Misha-Belov/Pneumatic-Joint/README.md

# Pneumatic-Joint
fabrika-project

## 📌 Описание
Проект представляет собой прототип суставана на базе микроконтроллера **ESP32**, изгибающегося за счёт перераспределения давления в эластичных камерах - мышцах. Управление и передача информации с датчика гироскопа в рельном времени осуществляется через Wi-Fi.

## 👨‍🔧 Участники проекта

- **Белов М.С. Б01-302**
- **Мартыненко Е.В. Б01-302** 

## 🎯 Цель проекта

Создание прототипа сустава на ESP32 с дальнейшей возможностью расширения на полноценный манипулятор.

## 🛠 Задачи

1. Подбор компонентов
2. Создание 3D-модели и электронной схемы
3. Написание прошивки
4. Сборка системы

## 🧩 Архитектура устройства

- **ESP32** с поддержкой Wi-Fi
- **Гироскоп-акселерометр** MPU6050
- **Понижатель напряжения**
- **3 соленоидных клапана**
- **Пневматическая система**

## 🆚 Аналоги и отличия

**Аналоги:**
- [Пневматический манипулятор на Habr]([https://habr.com/ru/articles/814127/](https://www.instructables.com/Soft-Robots-Make-An-Artificial-Muscle-Arm-And-Gri/))

**Отличительные особенности:**
- Значительно упрощённая пневматическая система
- Расширяемая архитектура для новых модулей
