Misha-Belov/Pneumatic-Joint/docs/Презентация1.pptx

## Пневматический сустав

Белов Михаил, Мартыненко Егор Б01-302

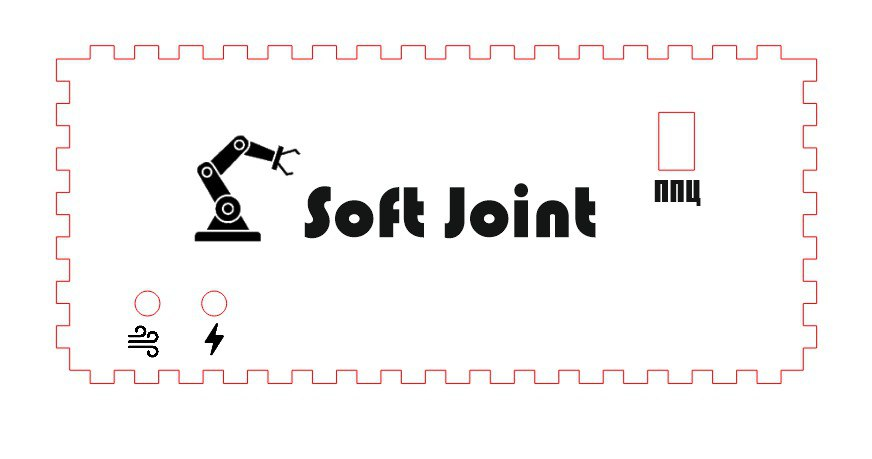
[picture p1: figure]

## Slide 2

Цели:
- Создание прототипа сустава на ESP32 с дальнейшей возможностью расширения на полноценный манипулятор.
Задачи:
- Подбор компонентов
- Создание 3D-модели и электронной схемы
- Написание прошивки
- Сборка системы

## Система подачи воздуха

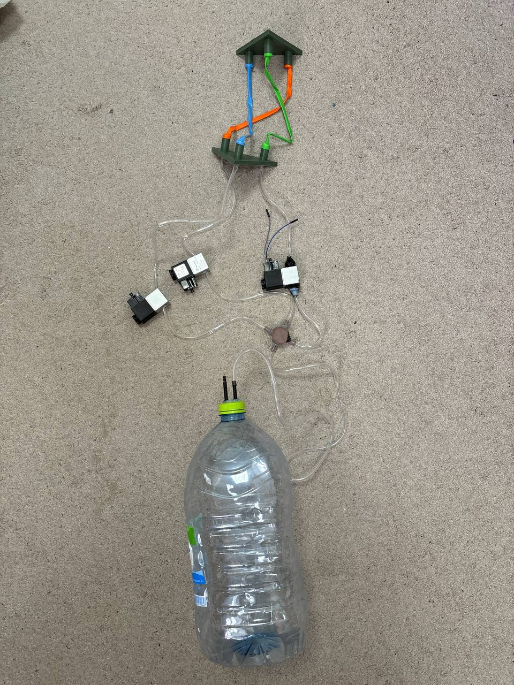
[picture p2: figure]
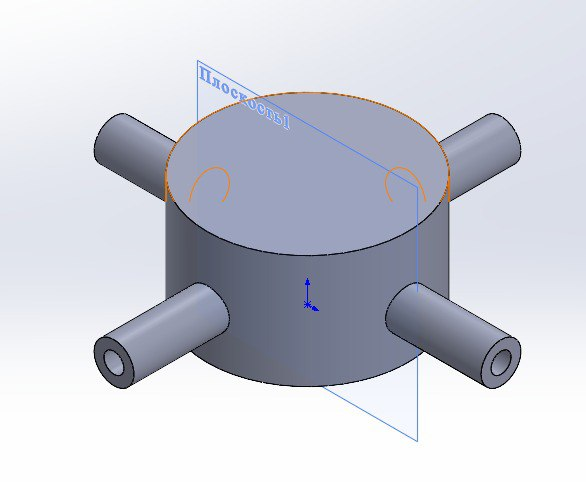
[picture p3: figure]

## Воздушные мыщцы

- Было принято решение перейти от сложных самодельных “гофр” на длинные резиновые шарики, которые надуваются по большей части в одну сторону

## Управляющая электроника

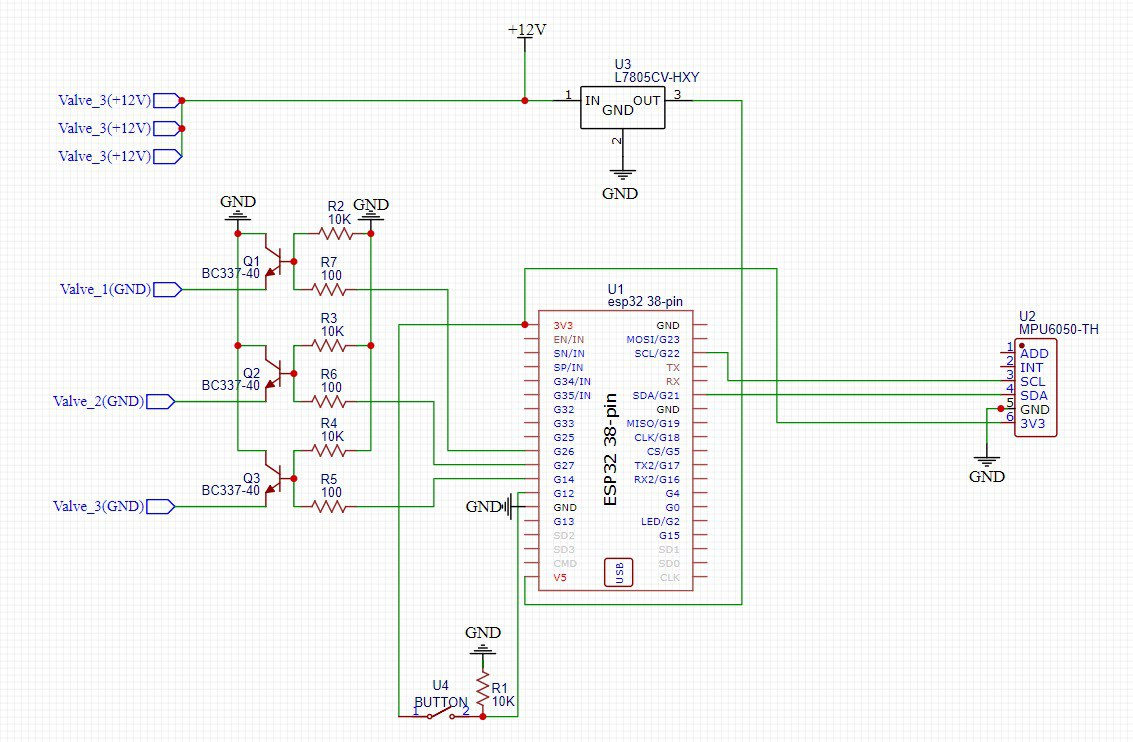
[picture p4: figure]

## Результаты

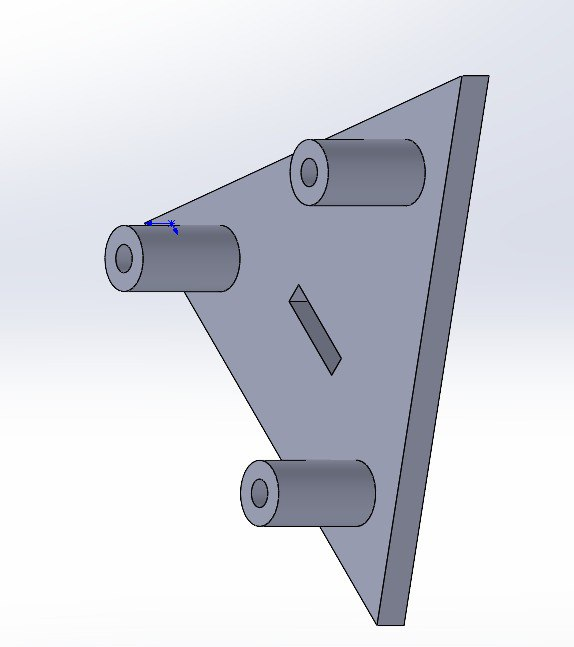
[picture p5: figure]
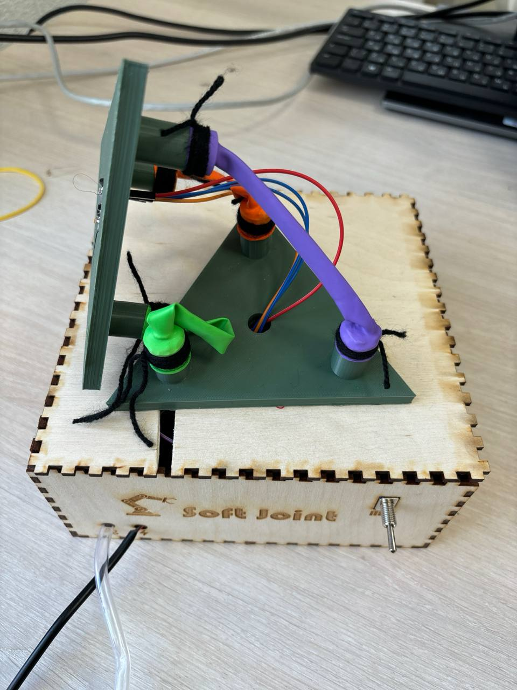
[picture p6: figure]
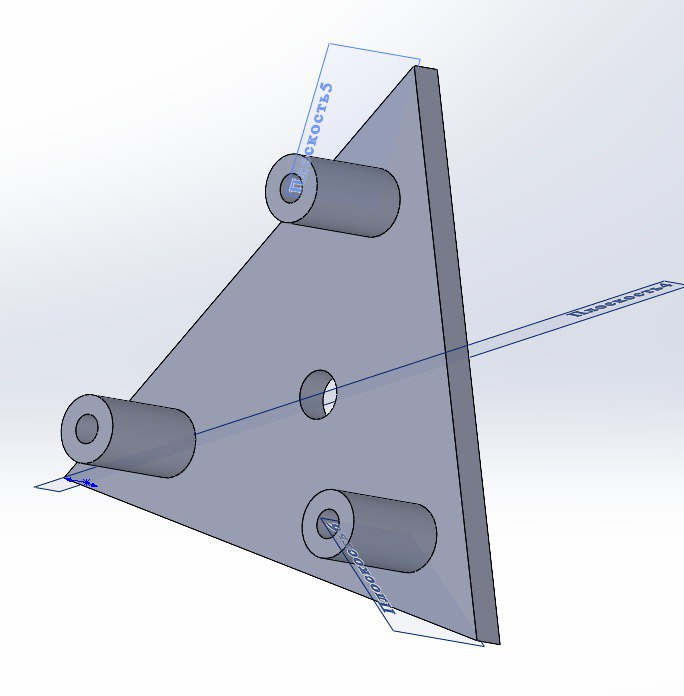
[picture p7: figure]

## Перспективы развития
