Misha-Belov/Pneumatic-Joint/docs/poster.pdf

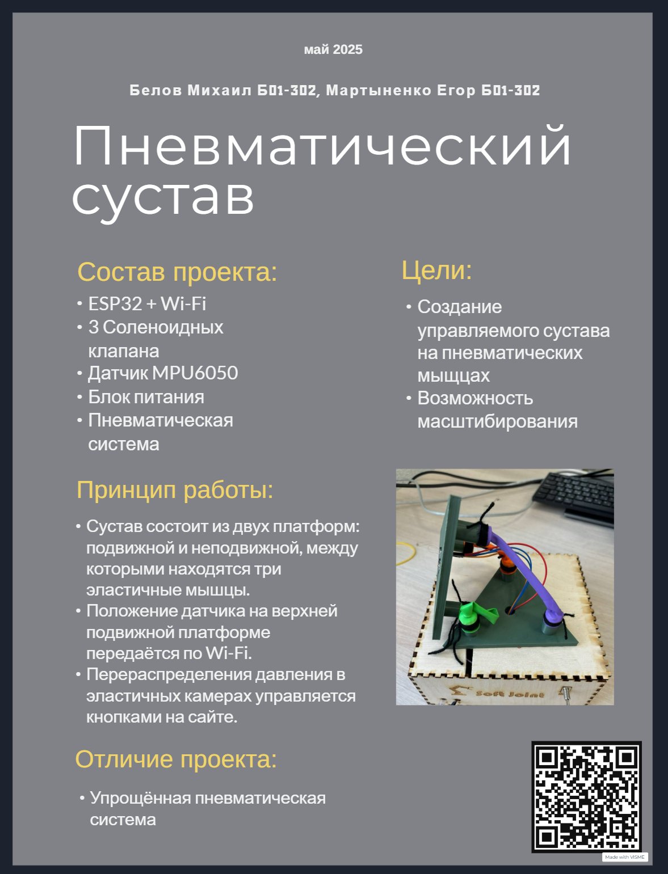
[picture p8: page 1]
