Misha-Belov/Pneumatic-Joint/data/rotator.png

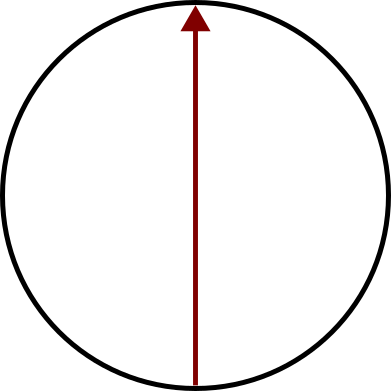
data/rotator.png
