Misha-Belov/Pneumatic-Joint/models/joint_controlbox.SLDASM

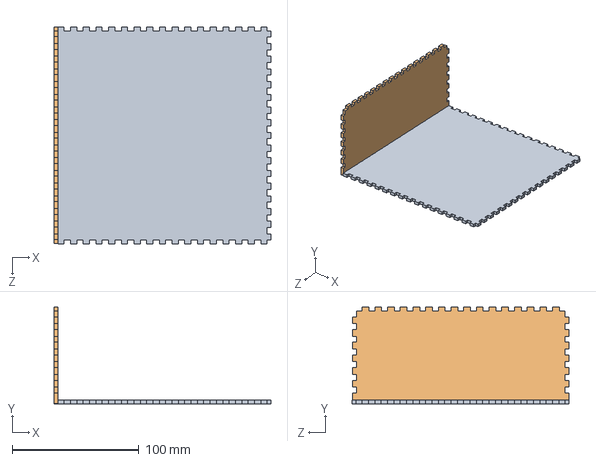
[picture p10: CAD file, 2025-05-22]
models/joint_controlbox.SLDASM
171.0 x 76.2 x 171.0 mm
joint_controlbox_bottom
joint_controlbox_side
