Misha-Belov/Pneumatic-Joint/models/joint_controlbox_front.SLDPRT

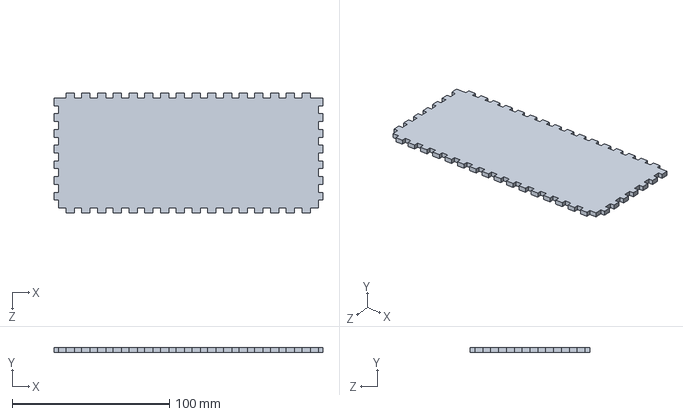
[picture p11: CAD file, 2025-05-22]
models/joint_controlbox_front.SLDPRT
171.0 x 3.00 x 76.0 mm
