Misha-Belov/Pneumatic-Joint/models/joint_controlbox_top.SLDPRT

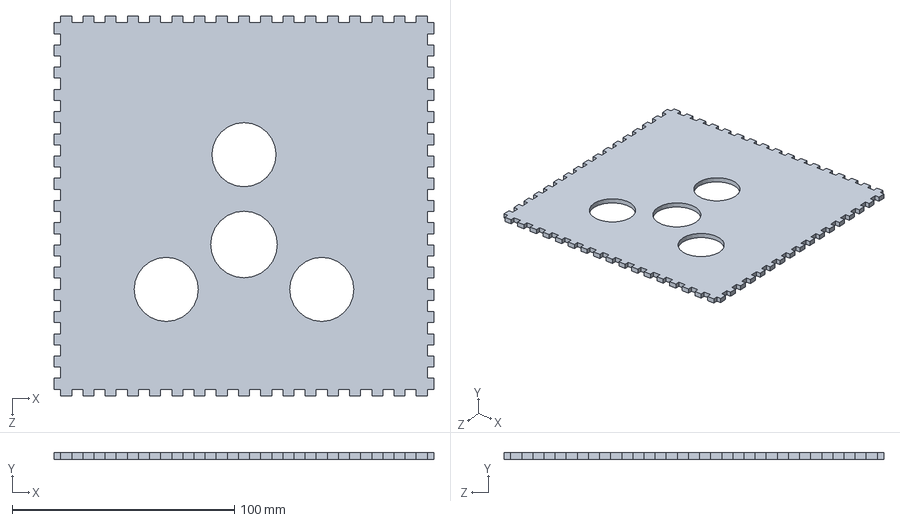
[picture p12: CAD file, 2025-05-22]
models/joint_controlbox_top.SLDPRT
171.0 x 3.00 x 171.0 mm
