Misha-Belov/Pneumatic-Joint/(list of files, cad)

Other CAD files:
models/joint_controlbox_side.SLDPRT
models/joint_controlbox_back.DXF
models/joint_controlbox_bottom.DXF
models/joint_controlbox_front.DXF
models/joint_controlbox_side.DXF
models/joint_controlbox_top.DXF
