Misha-Belov/Pneumatic-Joint/schematics/Schematic_ppc_2025-05-21.pdf

A | A

1

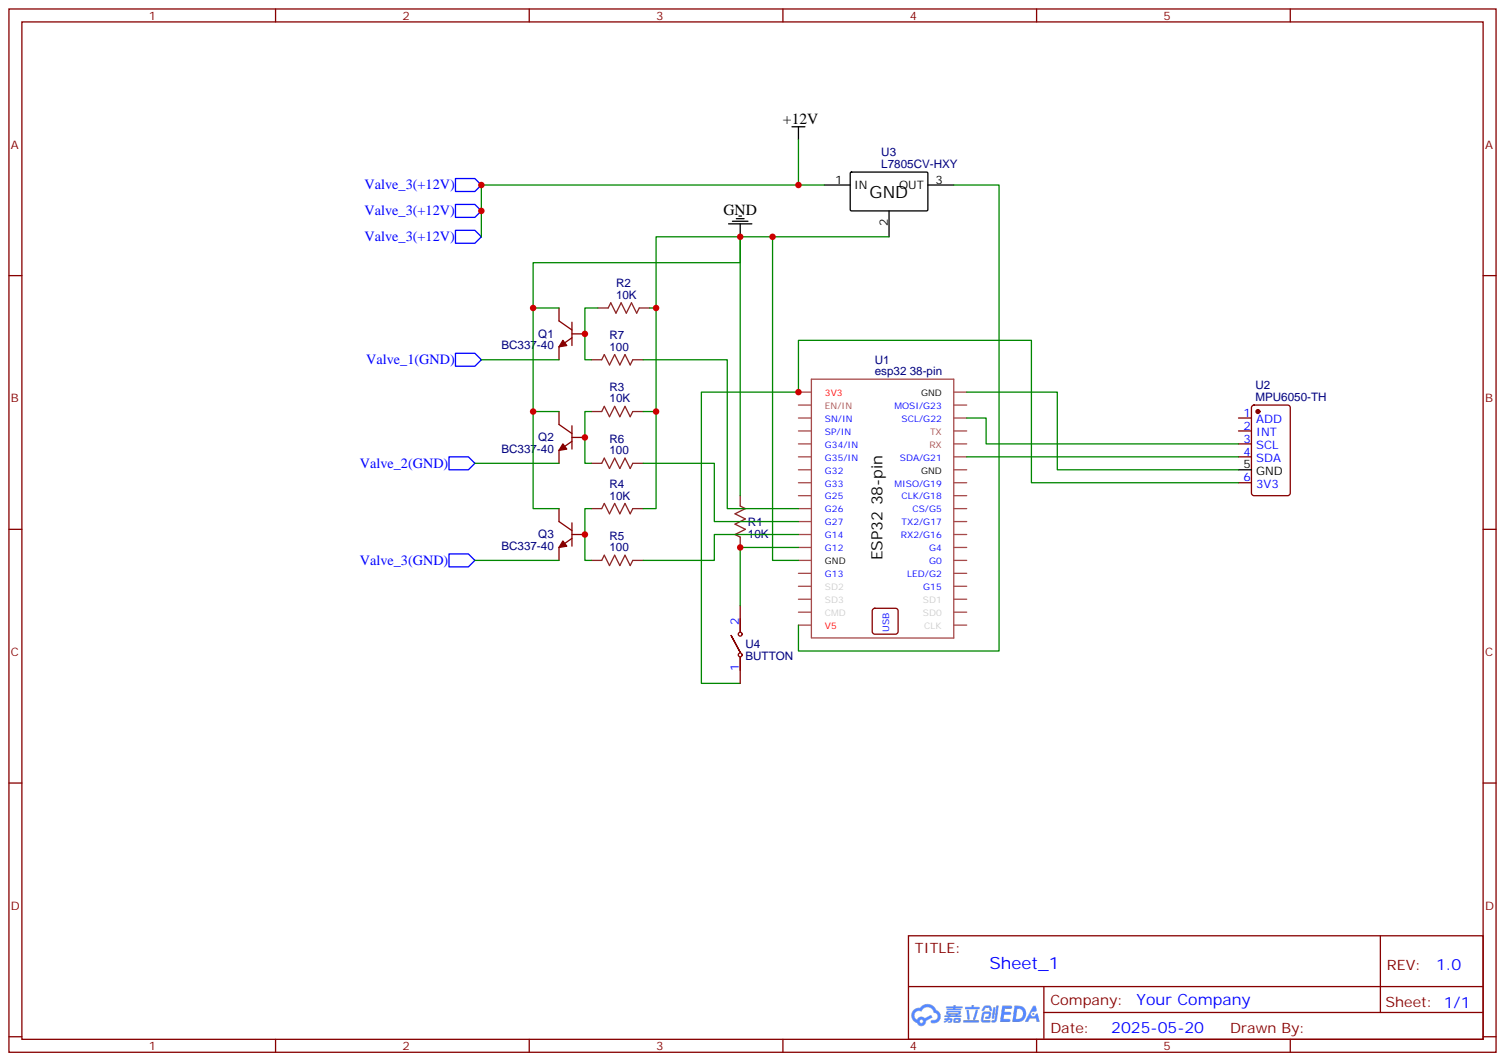
[picture p14: page 1]
