Misha-Belov/Pneumatic-Joint/(list of files, drawings)

Other design files:
schematics/SCH_ppc_2025-05-21.json
