Misha-Belov/Pneumatic-Joint/(commit log)

2025-05-22 сука миша блять ВИКТОРОВИЧ
2025-05-22 миша не умеет пользоваться гитом.
2025-05-22 я тоже.
2025-05-22 add models
    [SCH_ppc_2025-05-21.json, joint_controlbox.SLDASM, joint_controlbox_back.DXF, joint_controlbox_back.SLDPRT, joint_controlbox_bottom.DXF, joint_controlbox_bottom.SLDPRT, joint_controlbox_front.DXF, joint_controlbox_front.SLDPRT]
2025-05-23 закончил документы
